Manish-404/zip-ties-3d-bike/out/loads.md

| Loop tension | Per tooth | Bearing | Root shear | Fillet peak (FEM-scaled) | Core tension |
|---|---|---|---|---|---|
| 100 N | 50 N | 4.6 MPa | 2.0 MPa | 13.0 MPa | 2.8 MPa |
| 200 N | 100 N | 9.2 MPa | 4.1 MPa | 26.0 MPa | 5.6 MPa |
| 300 N | 150 N | 13.8 MPa | 6.1 MPa | 39.0 MPa | 8.3 MPa |

| Model | cc | Engine torque | Kerb | Rear tyre | Rear load | Traction force (snow) | Wheel torque (snow) | Loop tension, 1 strap | 2 straps | Wheel torque the lock can hold (1 / 2 straps) |
|---|---|---|---|---|---|---|---|---|---|---|
| Hunter 350 Retro | 349 | 27 Nm | 177 kg | 120/80-17 | 1360 N | 476 N | 144 Nm | 264 N | 132 N | 163 / 327 Nm |
| Hunter 350 Metro | 349 | 27 Nm | 181 kg | 140/70-17 | 1381 N | 483 N | 147 Nm | 269 N | 134 N | 164 / 329 Nm |
| Meteor 350 | 349 | 27 Nm | 191 kg | 140/70-17 | 1435 N | 502 N | 153 Nm | 279 N | 140 N | 164 / 329 Nm |
| Classic 350 | 349 | 27 Nm | 195 kg | 120/80-18 | 1457 N | 510 N | 161 Nm | 283 N | 142 N | 170 / 340 Nm |
| Himalayan 450 | 452 | 40 Nm | 196 kg | 140/80-17 | 1462 N | 512 N | 163 Nm | 284 N | 142 N | 172 / 344 Nm |
| Continental GT 650 | 648 | 52.3 Nm | 202 kg | 130/70-18 | 1495 N | 523 N | 162 Nm | 291 N | 145 N | 167 / 335 Nm |
| Interceptor 650 | 648 | 52 Nm | 213 kg | 130/70-18 | 1554 N | 544 N | 169 Nm | 302 N | 151 N | 167 / 335 Nm |
| Super Meteor 650 | 648 | 52.3 Nm | 241 kg | 150/80-16 | 1705 N | 597 N | 187 Nm | 332 N | 166 N | 169 / 339 Nm |
