Manish-404/zip-ties-3d-bike/docs/images/buckle.jpg

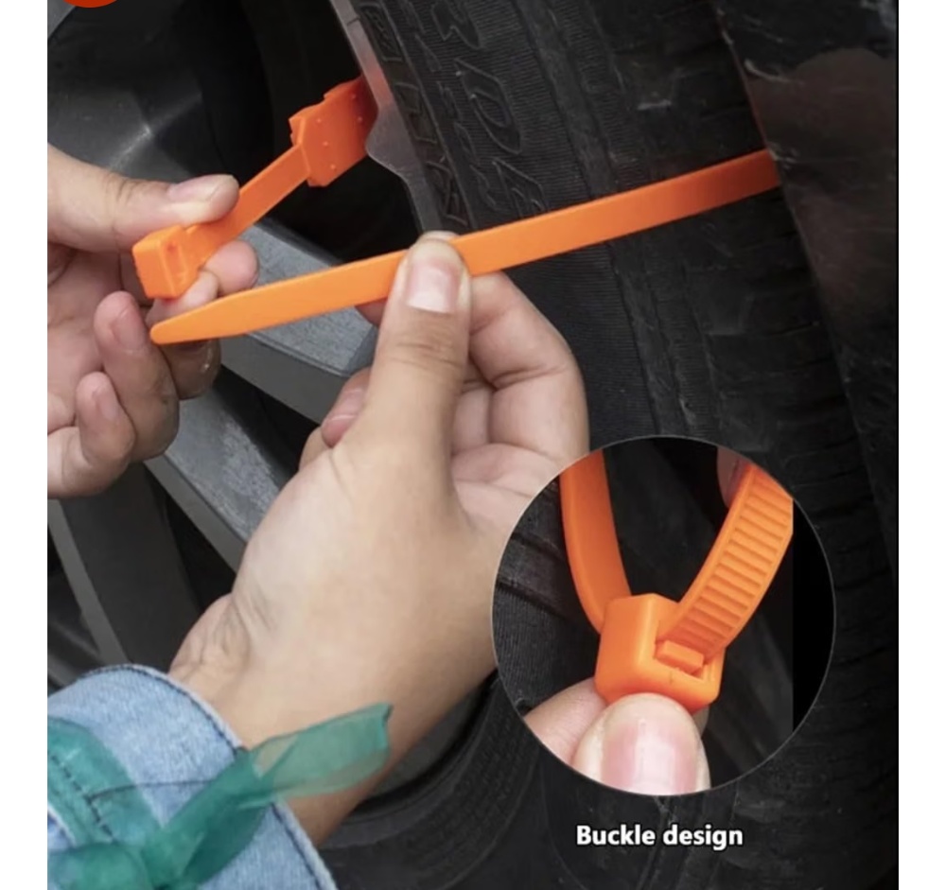
docs/images/buckle.jpg
