Manish-404/zip-ties-3d-bike/docs/images/features.jpg

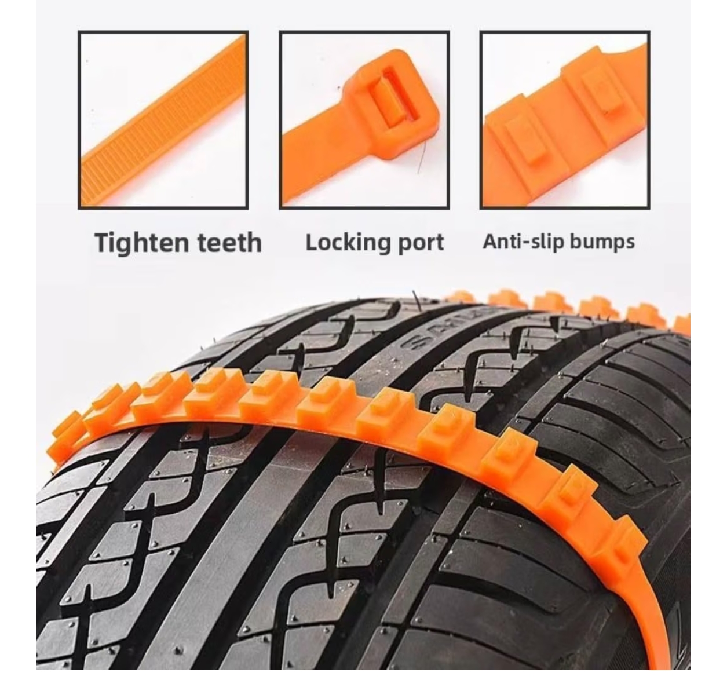
docs/images/features.jpg
