Manish-404/zip-ties-3d-bike/docs/images/lugs.jpg

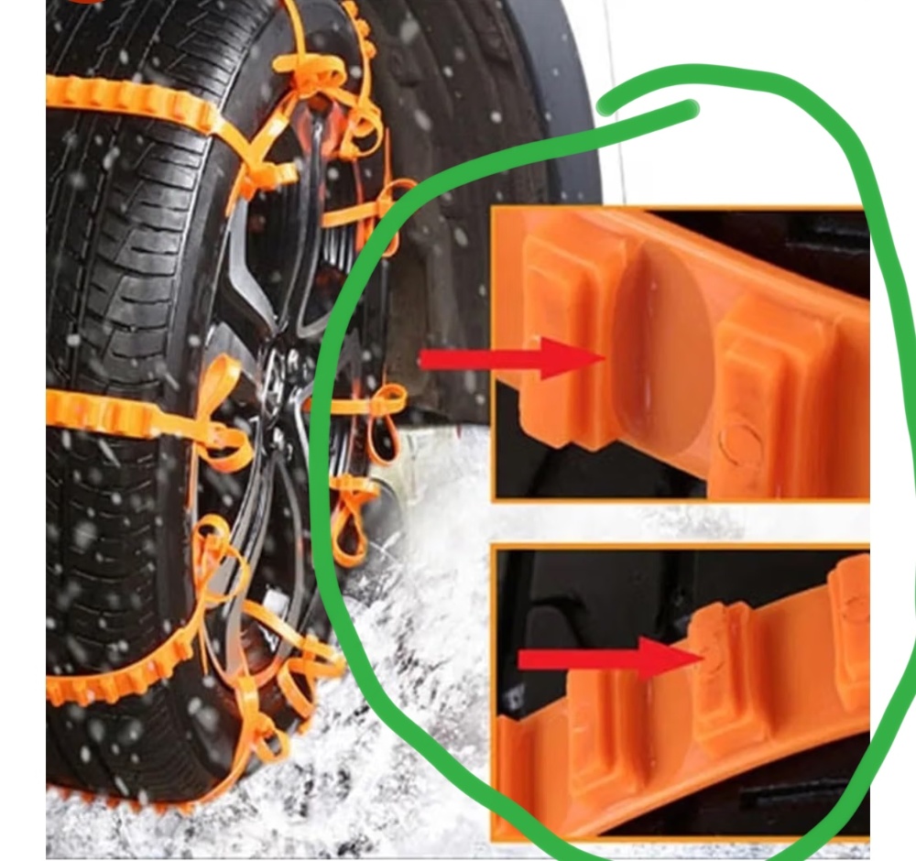
docs/images/lugs.jpg
