Manish-404/zip-ties-3d-bike/docs/images/plate_coupon.png

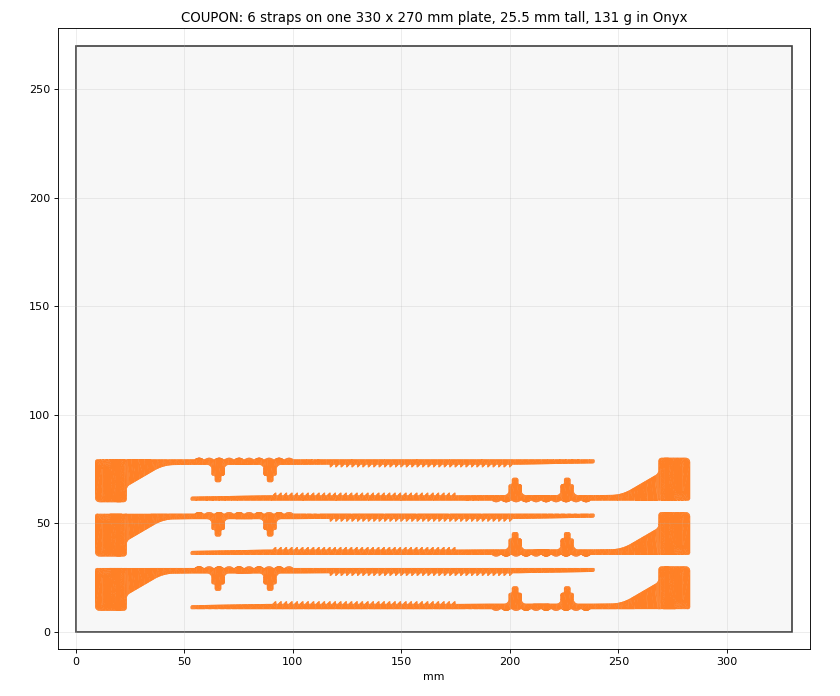
docs/images/plate_coupon.png
