Manish-404/zip-ties-3d-bike/docs/images/plate_metro_front.png

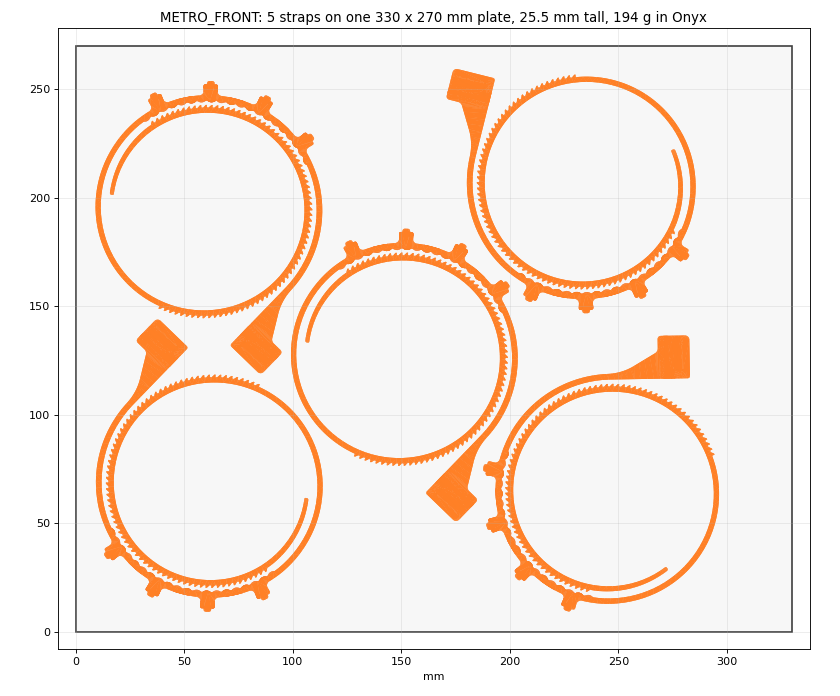
docs/images/plate_metro_front.png
