Manish-404/zip-ties-3d-bike/docs/images/plate_retro_rear.png

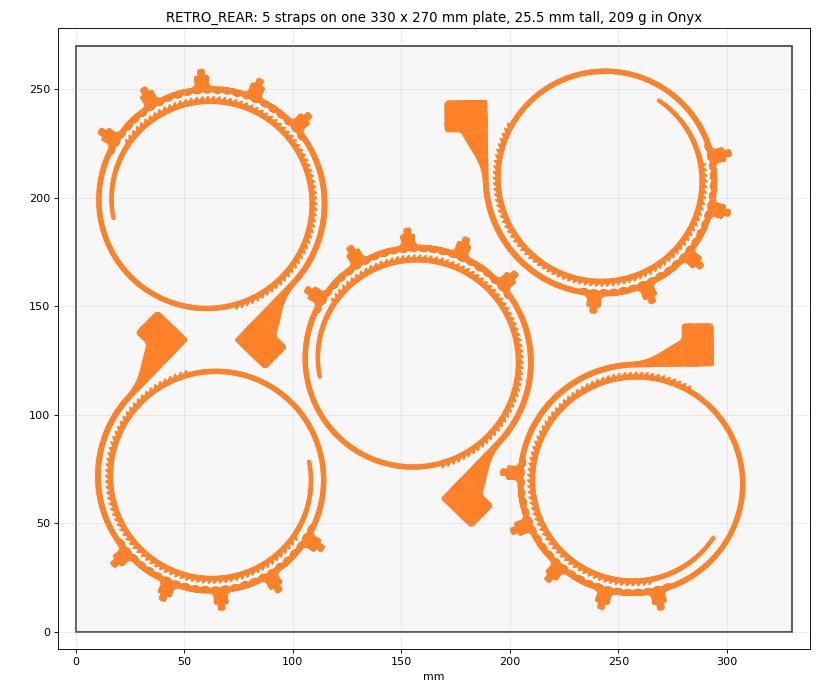
docs/images/plate_retro_rear.png
