Manish-404/zip-ties-3d-bike/docs/images/poster.jpg

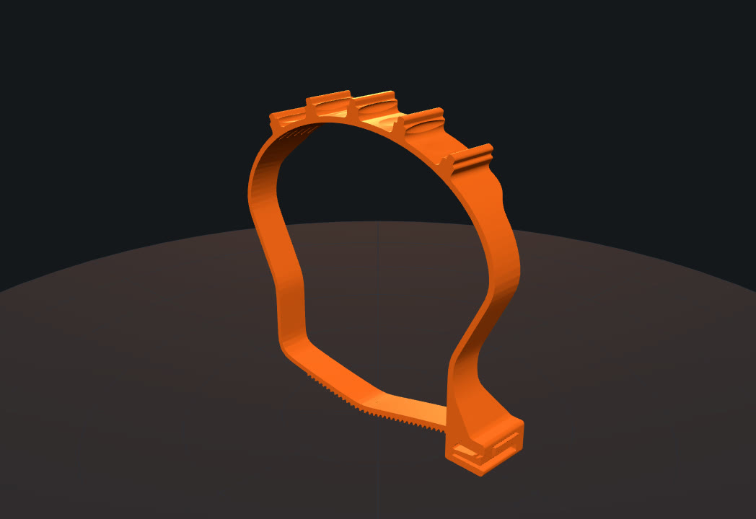
docs/images/poster.jpg
