Manish-404/zip-ties-3d-bike/docs/images/poster.png

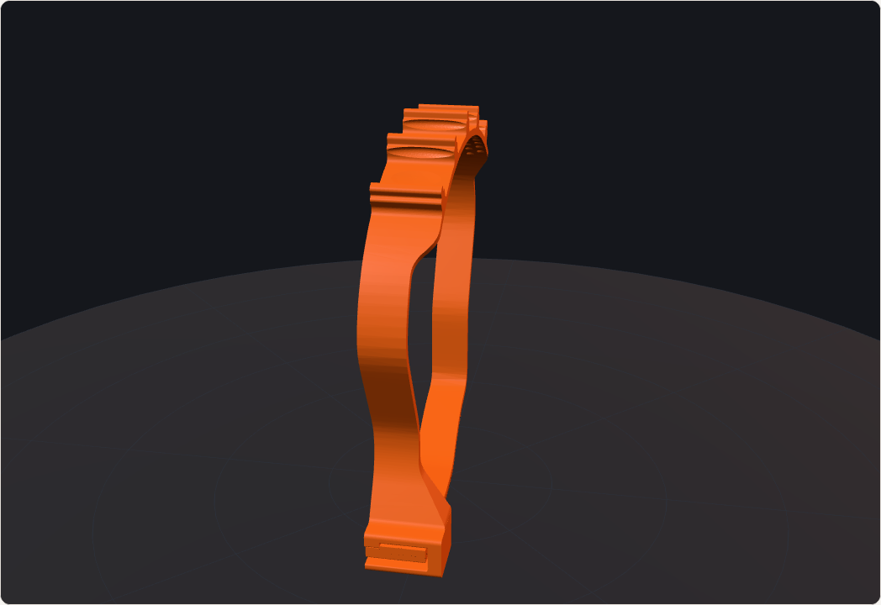
docs/images/poster.png
