Manish-404/zip-ties-3d-bike/docs/images/snow.jpg

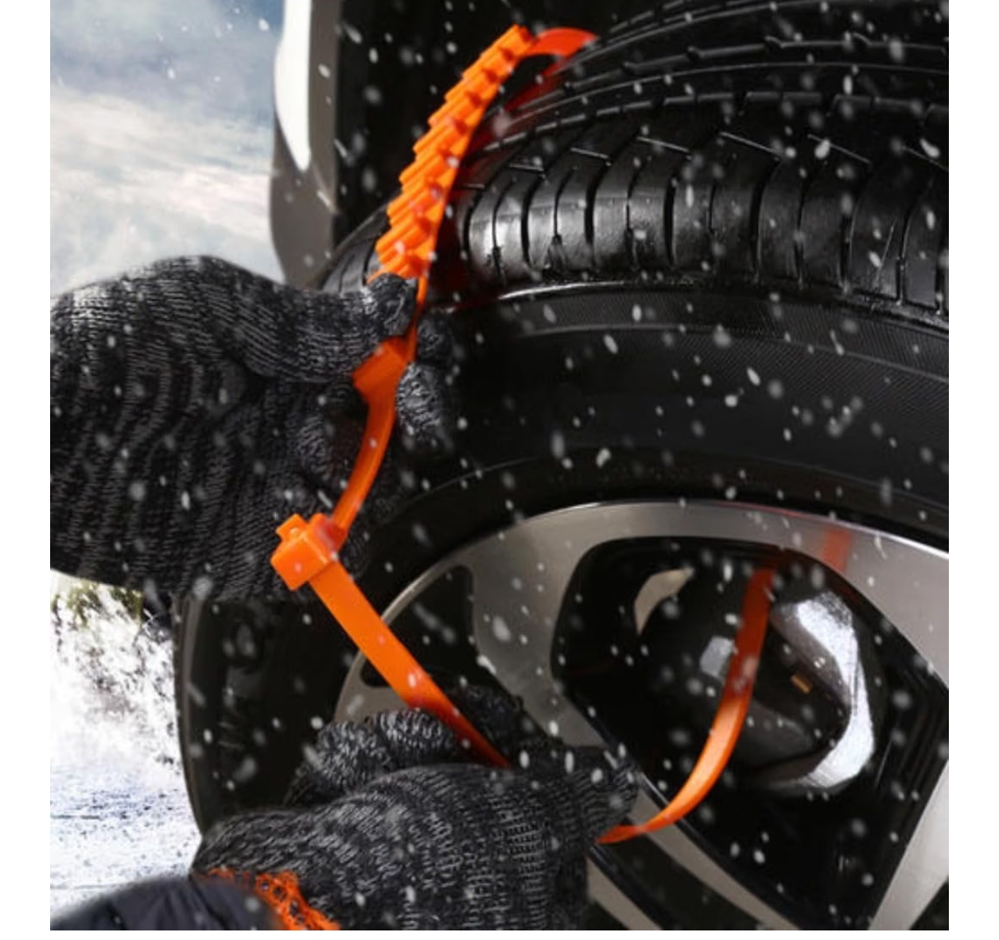
docs/images/snow.jpg
