Manish-404/zip-ties-3d-bike/docs/images/strap-fit.jpg

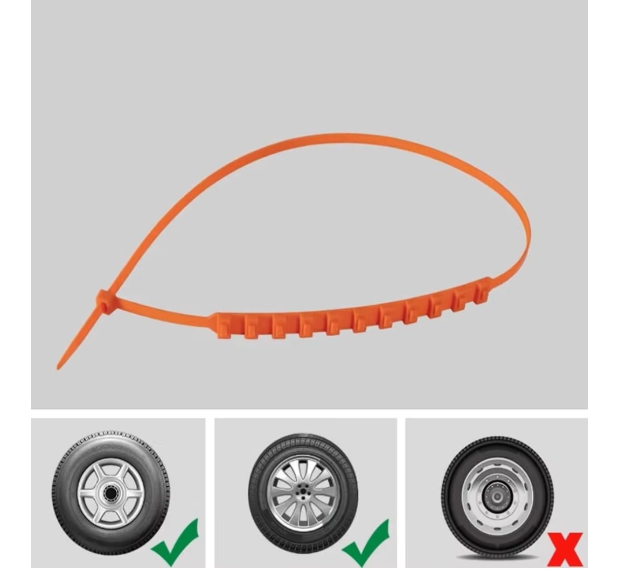
docs/images/strap-fit.jpg
