Manish-404/zip-ties-3d-bike/docs/images/v1_preview.png

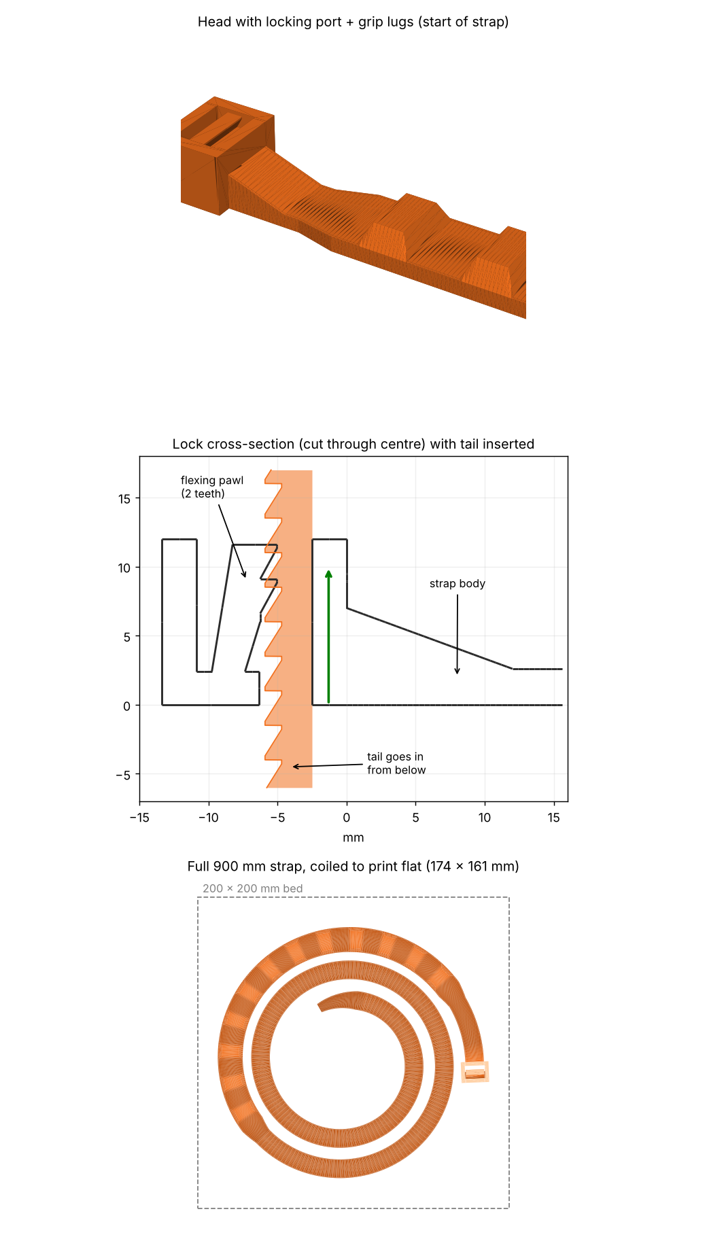
docs/images/v1_preview.png
