Manish-404/zip-ties-3d-bike/docs/models/hunter350_rear_loop.stl

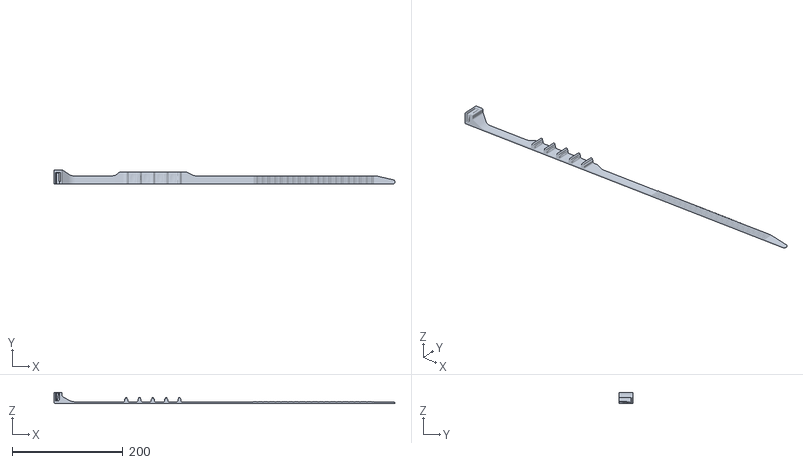
[picture p18: CAD file, 2026-10-31]
docs/models/hunter350_rear_loop.stl
615.0 x 25.5 x 20.4
