Manish-404/zip-ties-3d-bike/out/hunter350_snow_straps.FCStd

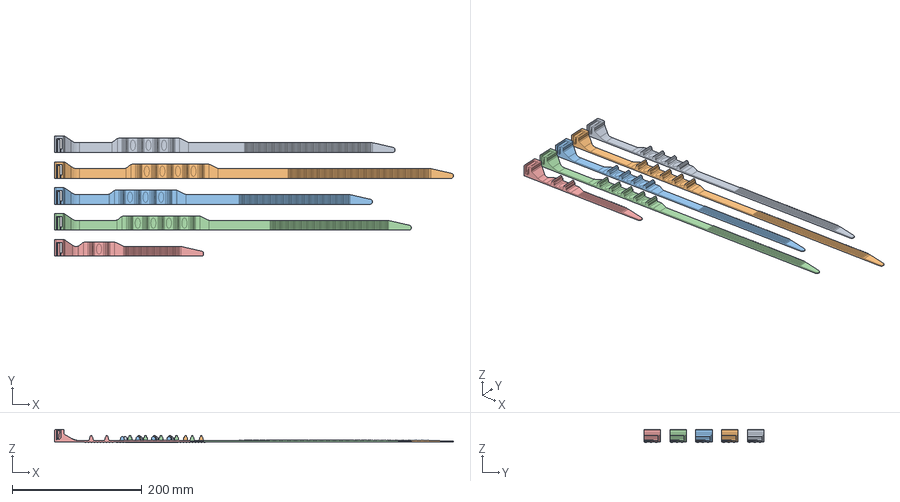
[picture p19: CAD file, 2026-10-31]
out/hunter350_snow_straps.FCStd
615.0 x 185.5 x 20.4 mm
Strap_METRO_FRONT
Strap_METRO_REAR
Strap_RETRO_FRONT
Strap_RETRO_REAR
Strap_COUPON
