Manish-404/zip-ties-3d-bike/out/lite/hunter350_coupon_lite.step

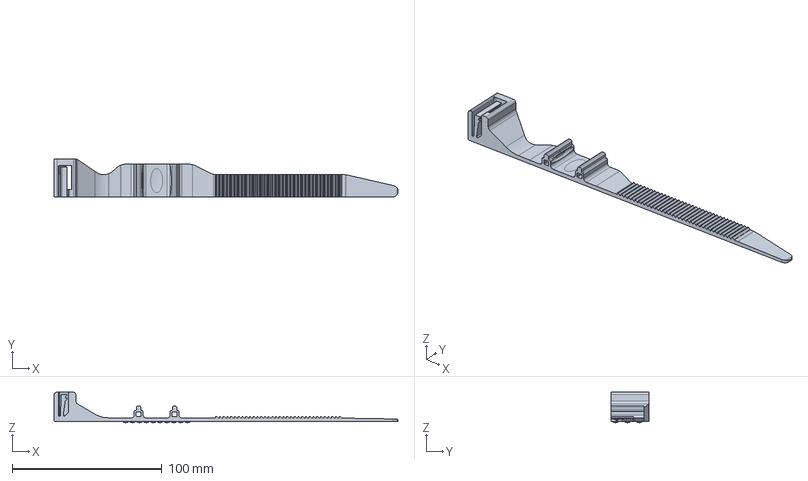
[picture p20: CAD file, 2026-10-31]
out/lite/hunter350_coupon_lite.step
230.0 x 25.5 x 20.4 mm
