Manish-404/zip-ties-3d-bike/out/lite/plates/hunter350_coupon_lite_PLATE_6up.stl

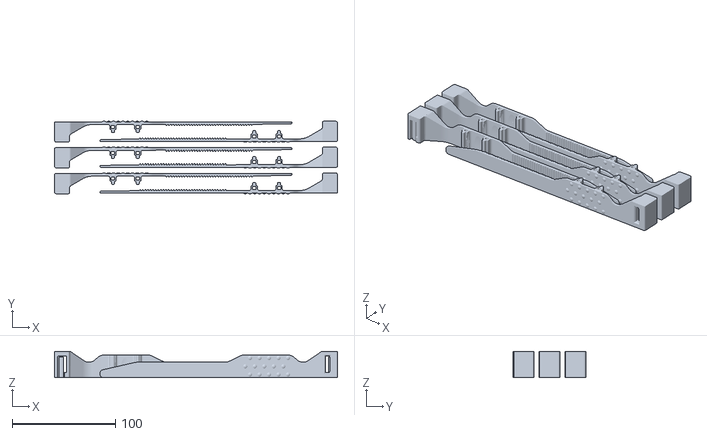
[picture p21: CAD file, 2026-10-31]
out/lite/plates/hunter350_coupon_lite_PLATE_6up.stl
274.0 x 70.4 x 25.5
