Manish-404/zip-ties-3d-bike/out/lite_rect/hunter350_metro_front_rect_lite_PRINT_on_edge_coil.stl

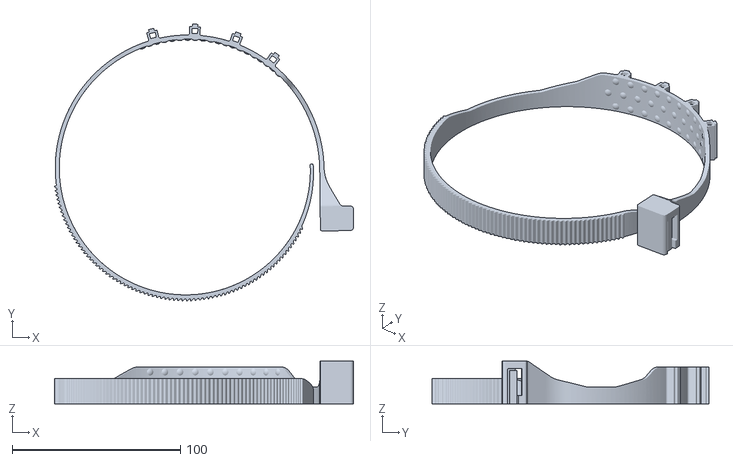
[picture p22: CAD file, 2026-10-31]
out/lite_rect/hunter350_metro_front_rect_lite_PRINT_on_edge_coil.stl
177.7 x 164.6 x 25.5
