Manish-404/zip-ties-3d-bike/out/lite_rect/plates/hunter350_metro_front_rect_lite_PLATE_5up.stl

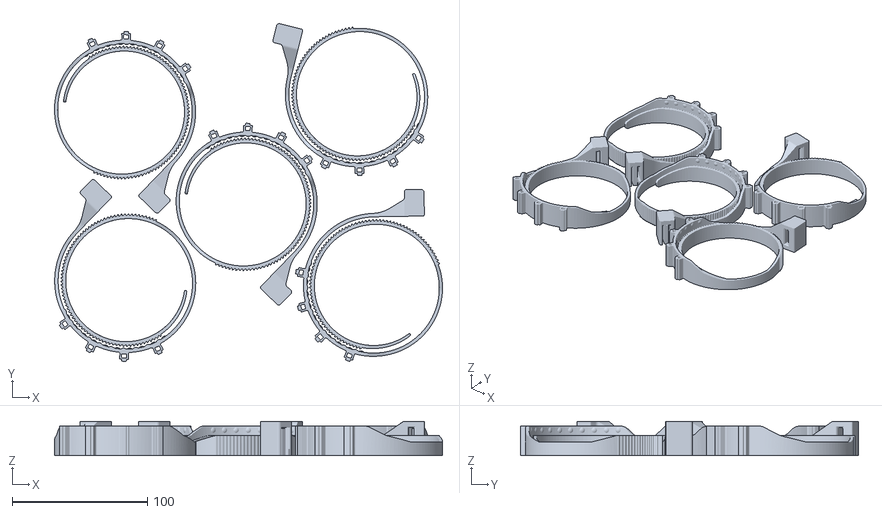
[picture p23: CAD file, 2026-10-31]
out/lite_rect/plates/hunter350_metro_front_rect_lite_PLATE_5up.stl
287.1 x 249.9 x 25.5
