Manish-404/zip-ties-3d-bike/out/plates/hunter350_retro_rear_PLATE_5up.stl

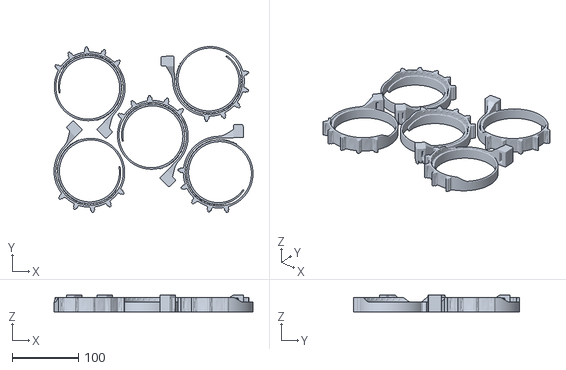
[picture p24: CAD file, 2026-10-31]
out/plates/hunter350_retro_rear_PLATE_5up.stl
299.4 x 249.6 x 25.5
