Manish-404/zip-ties-3d-bike/out/rect/hunter350_metro_rear_rect.step

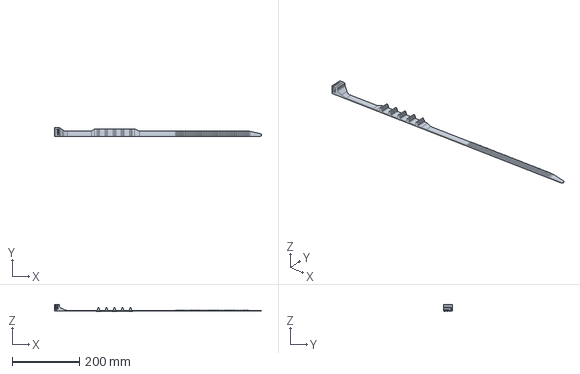
[picture p25: CAD file, 2026-10-31]
out/rect/hunter350_metro_rear_rect.step
615.0 x 25.5 x 20.4 mm
