Manish-404/zip-ties-3d-bike/out/hunter350_coupon_straight.stl

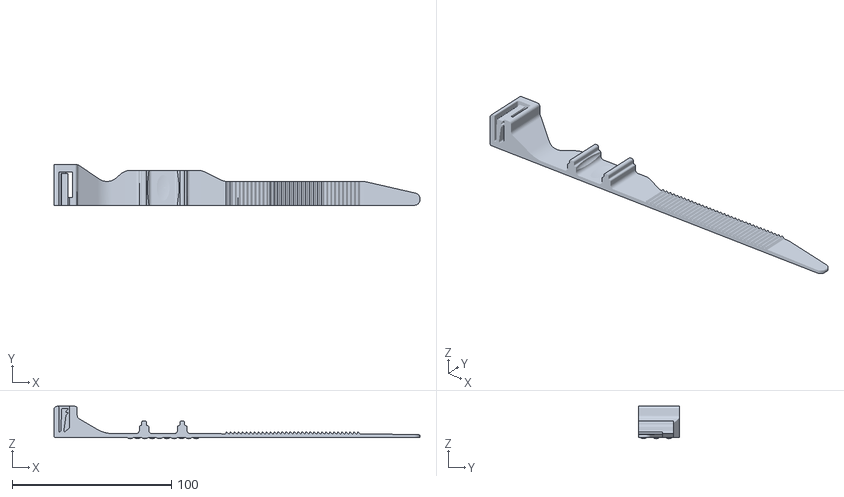
[picture p26: CAD file, 2026-10-31]
out/hunter350_coupon_straight.stl
230.0 x 25.5 x 20.4
