Manish-404/zip-ties-3d-bike/out/lite_rect/plates/hunter350_metro_rear_rect_lite_PLATE_5up.stl

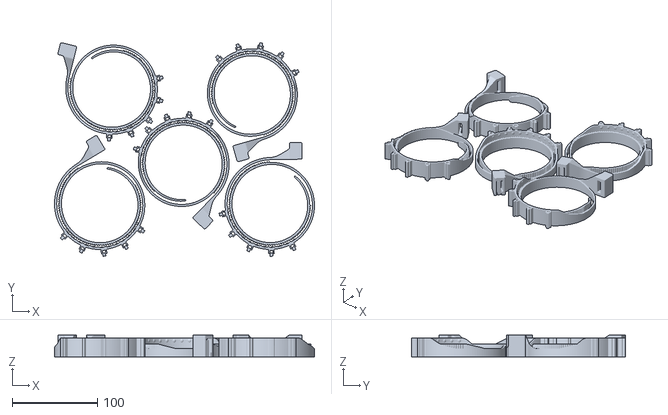
[picture p27: CAD file, 2026-10-31]
out/lite_rect/plates/hunter350_metro_rear_rect_lite_PLATE_5up.stl
305.0 x 250.6 x 25.5
