Manish-404/zip-ties-3d-bike/out/plates/hunter350_coupon_PLATE_6up.stl

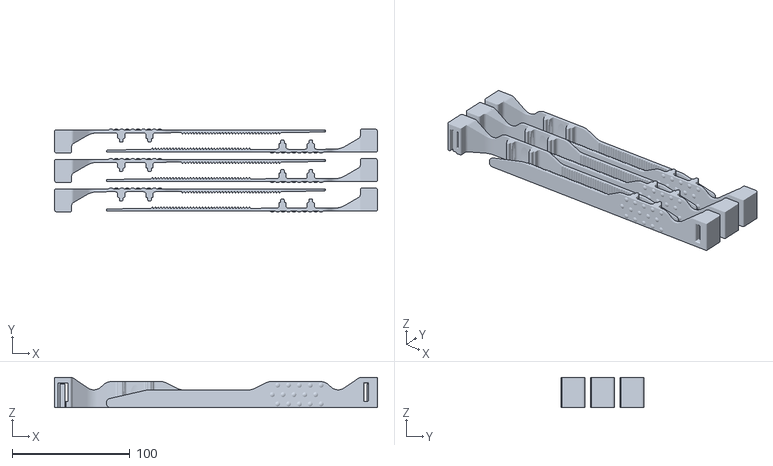
[picture p28: CAD file, 2026-10-31]
out/plates/hunter350_coupon_PLATE_6up.stl
274.0 x 70.4 x 25.5
