Manish-404/zip-ties-3d-bike/out/rect/hunter350_retro_front_rect_straight.stl

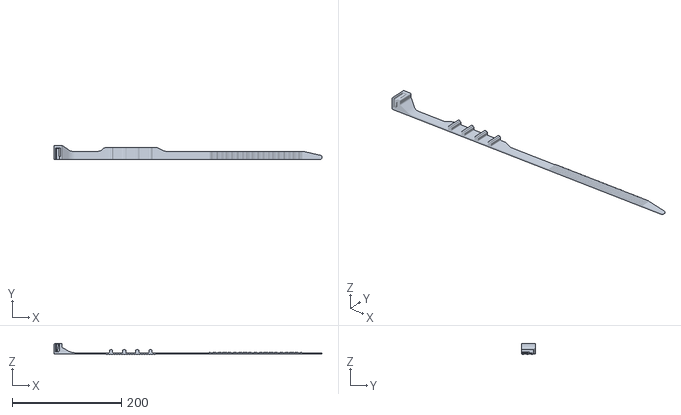
[picture p29: CAD file, 2026-10-31]
out/rect/hunter350_retro_front_rect_straight.stl
490.0 x 25.5 x 20.4
