Manish-404/zip-ties-3d-bike/docs/models/hunter350_front_straight.stl

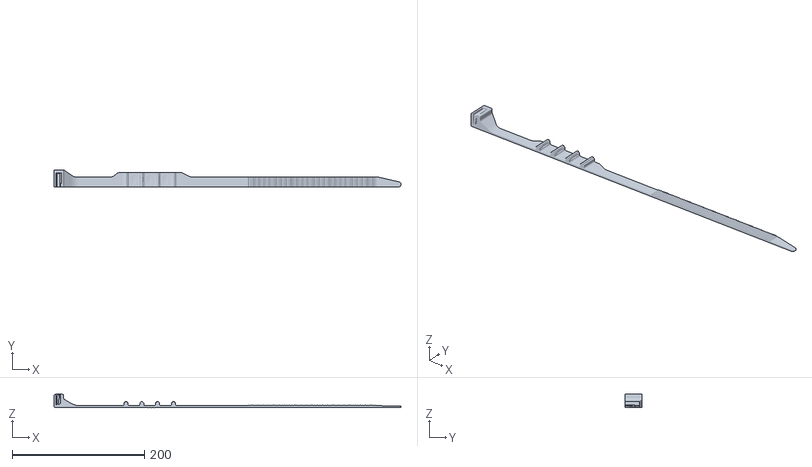
[picture p30: CAD file, 2026-10-31]
docs/models/hunter350_front_straight.stl
525.0 x 25.5 x 20.4
