Manish-404/zip-ties-3d-bike/out/hunter350_metro_rear_PRINT_on_edge_coil.stl

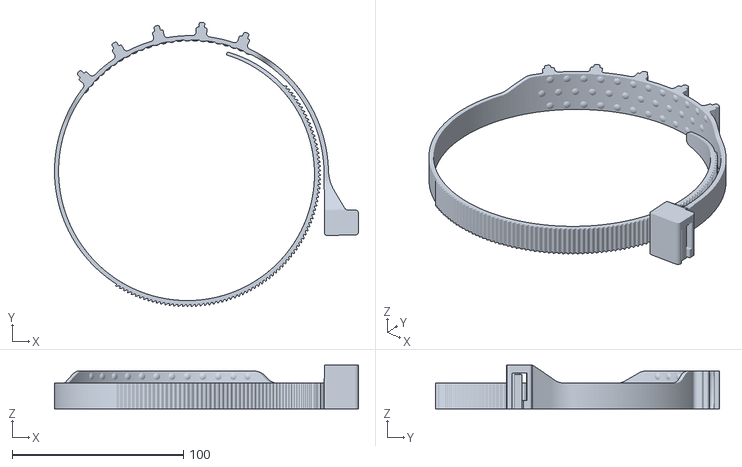
[picture p31: CAD file, 2026-10-31]
out/hunter350_metro_rear_PRINT_on_edge_coil.stl
177.3 x 165.9 x 25.5
