Manish-404/zip-ties-3d-bike/out/lite/plates/hunter350_retro_front_lite_PLATE_5up.stl

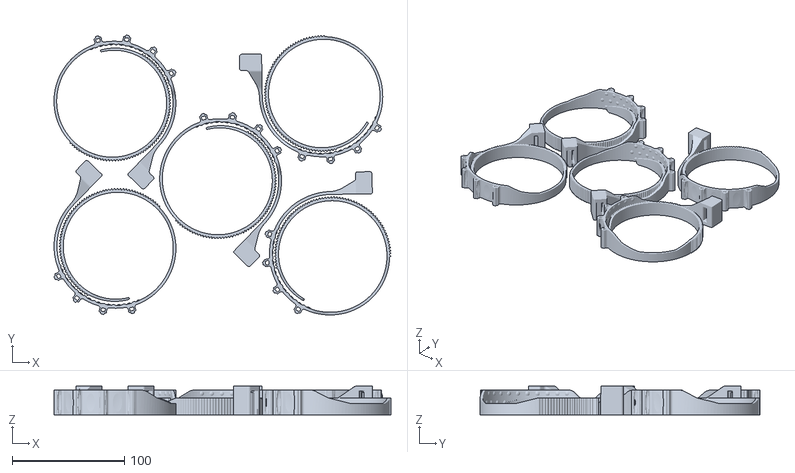
[picture p32: CAD file, 2026-10-31]
out/lite/plates/hunter350_retro_front_lite_PLATE_5up.stl
299.8 x 249.0 x 25.5
