Manish-404/zip-ties-3d-bike/out/lite_rect/hunter350_retro_front_rect_lite_PRINT_on_edge_coil.stl

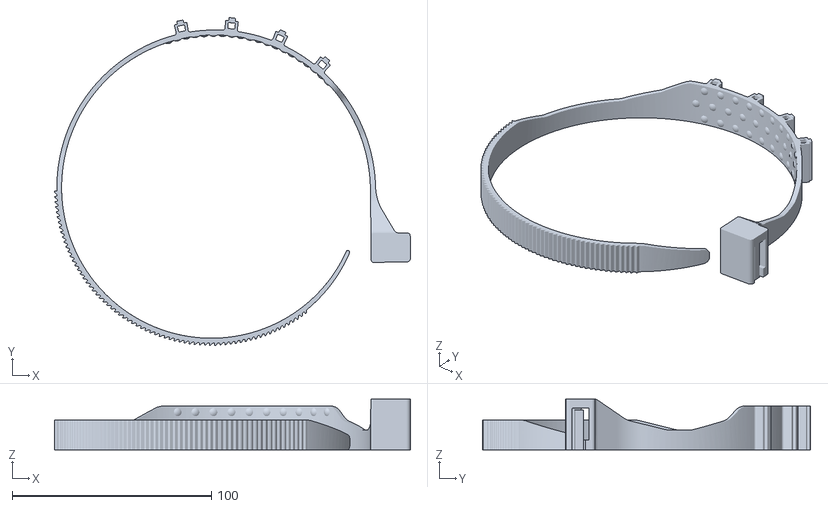
[picture p33: CAD file, 2026-10-31]
out/lite_rect/hunter350_retro_front_rect_lite_PRINT_on_edge_coil.stl
178.5 x 164.3 x 25.5
