Manish-404/zip-ties-3d-bike/out/lite_rect/hunter350_retro_rear_rect_lite_straight.stl

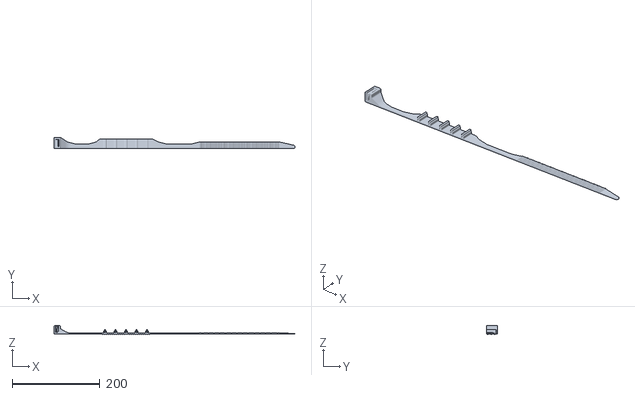
[picture p35: CAD file, 2026-10-31]
out/lite_rect/hunter350_retro_rear_rect_lite_straight.stl
550.0 x 25.5 x 20.4
