Manish-404/zip-ties-3d-bike/out/lite/plates/hunter350_metro_rear_lite_PLATE_5up.stl

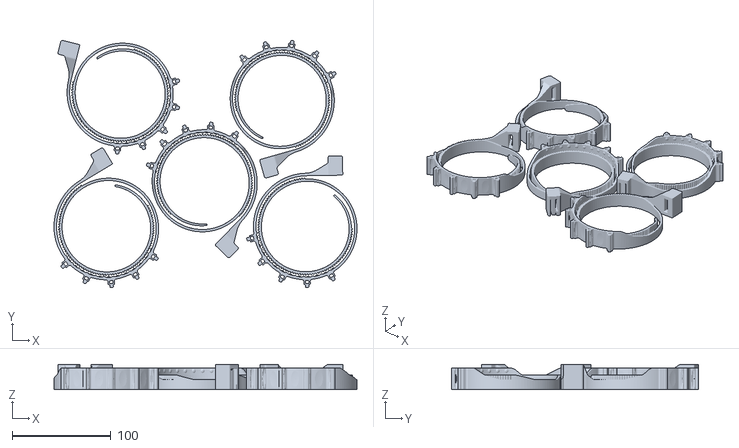
[picture p36: CAD file, 2026-10-31]
out/lite/plates/hunter350_metro_rear_lite_PLATE_5up.stl
307.0 x 250.5 x 25.5
