Manish-404/zip-ties-3d-bike/out/hunter350_metro_front_installed_pose.stl

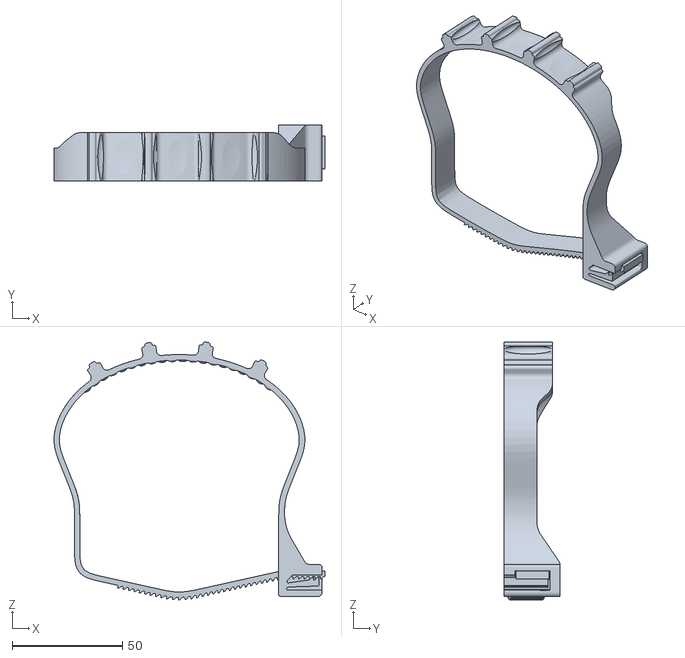
[picture p37: CAD file, 2026-10-31]
out/hunter350_metro_front_installed_pose.stl
122.9 x 25.5 x 117.0
