Manish-404/zip-ties-3d-bike/out/lite/hunter350_retro_rear_lite_PRINT_on_edge_coil.stl

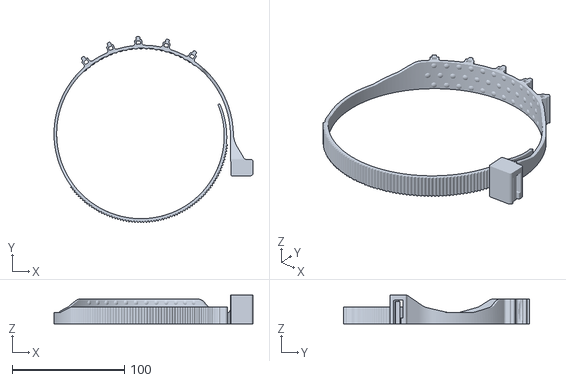
[picture p38: CAD file, 2026-10-31]
out/lite/hunter350_retro_rear_lite_PRINT_on_edge_coil.stl
177.3 x 166.0 x 25.5
