Manish-404/zip-ties-3d-bike/out/hunter350_retro_rear_installed_pose.stl

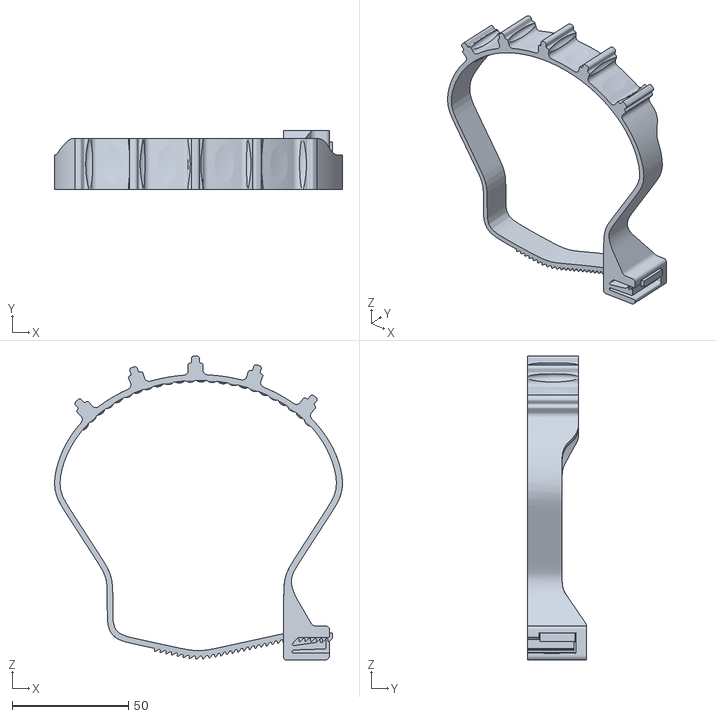
[picture p39: CAD file, 2026-10-31]
out/hunter350_retro_rear_installed_pose.stl
123.9 x 25.5 x 130.7
