Manish-404/zip-ties-3d-bike/out/lite/hunter350_retro_front_lite_straight.stl

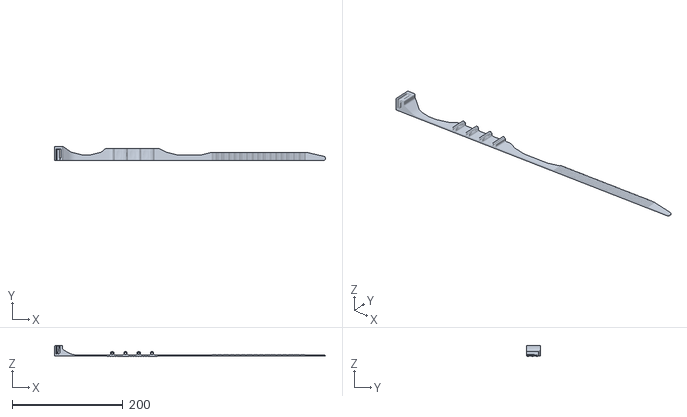
[picture p40: CAD file, 2026-10-31]
out/lite/hunter350_retro_front_lite_straight.stl
490.0 x 25.5 x 20.4
