Manish-404/zip-ties-3d-bike/out/rect/hunter350_metro_rear_rect_installed_pose.stl

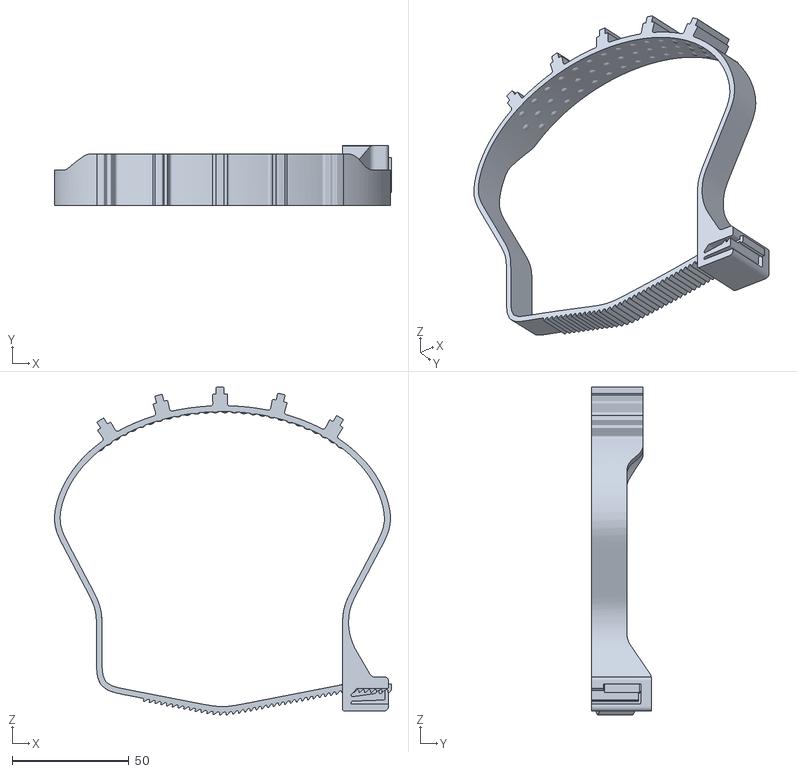
[picture p42: CAD file, 2026-10-28]
out/rect/hunter350_metro_rear_rect_installed_pose.stl
144.3 x 25.5 x 140.4
