Manish-404/zip-ties-3d-bike/out/rect/hunter350_retro_front_rect_installed_pose.stl

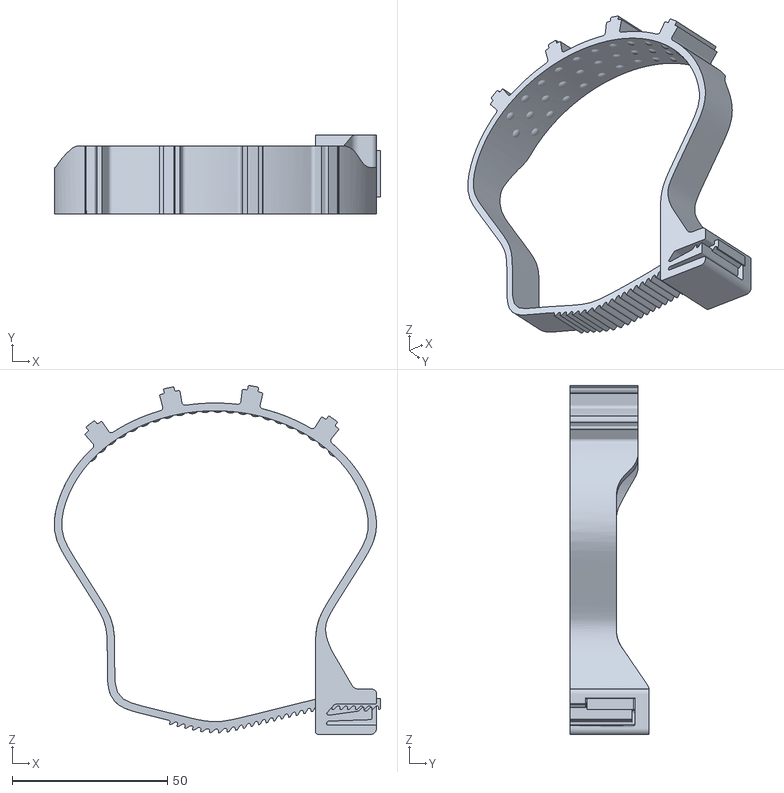
[picture p43: CAD file, 2026-10-28]
out/rect/hunter350_retro_front_rect_installed_pose.stl
105.0 x 25.5 x 112.4
