Manish-404/zip-ties-3d-bike/(list of files, cad)

Other CAD files:
out/rect/plates/hunter350_retro_rear_rect_PLATE_5up.stl
out/lite/hunter350_snow_straps.FCStd
out/lite/plates/hunter350_metro_front_lite_PLATE_5up.stl
out/lite_rect/hunter350_coupon_rect_lite.step
out/rect/plates/hunter350_coupon_rect_PLATE_6up.stl
out/lite/hunter350_metro_rear_lite_straight.stl
out/plates/hunter350_metro_front_PLATE_5up.stl
out/rect/hunter350_retro_front_rect.step
out/rect/plates/hunter350_metro_front_rect_PLATE_5up.stl
out/hunter350_metro_front_PRINT_on_edge_coil.stl
out/lite/hunter350_coupon_lite_straight.stl
out/lite/plates/hunter350_retro_rear_lite_PLATE_5up.stl
out/lite_rect/plates/hunter350_retro_front_rect_lite_PLATE_5up.stl
out/plates/hunter350_retro_front_PLATE_5up.stl
out/rect/hunter350_coupon_rect.step
out/rect/plates/hunter350_retro_front_rect_PLATE_5up.stl
out/lite/hunter350_metro_rear_lite.step
out/lite_rect/hunter350_coupon_rect_lite_PRINT_on_edge.stl
out/lite_rect/plates/hunter350_retro_rear_rect_lite_PLATE_5up.stl
out/plates/hunter350_metro_rear_PLATE_5up.stl
out/rect/hunter350_coupon_rect_PRINT_on_edge.stl
out/rect/plates/hunter350_metro_rear_rect_PLATE_5up.stl
out/lite/hunter350_metro_rear_lite_PRINT_on_edge_coil.stl
out/lite_rect/hunter350_metro_rear_rect_lite.step
out/rect/hunter350_metro_front_rect.step
out/hunter350_retro_front_PRINT_on_edge_coil.stl
out/lite_rect/hunter350_retro_rear_rect_lite.step
out/rect/hunter350_coupon_rect_straight.stl
out/hunter350_coupon.step
out/lite/hunter350_metro_front_lite_straight.stl
out/lite_rect/hunter350_metro_rear_rect_lite_straight.stl
out/rect/hunter350_metro_rear_rect_straight.stl
out/hunter350_retro_rear_straight.stl
out/lite/hunter350_metro_front_lite.step
out/lite_rect/hunter350_metro_rear_rect_lite_PRINT_on_edge_coil.stl
out/rect/hunter350_retro_front_rect_PRINT_on_edge_coil.stl
out/hunter350_coupon_PRINT_on_edge.stl
out/lite/hunter350_metro_front_lite_PRINT_on_edge_coil.stl
out/lite_rect/hunter350_metro_front_rect_lite.step
out/rect/hunter350_retro_rear_rect_straight.stl
out/lite/hunter350_retro_front_lite_PRINT_on_edge_coil.stl
out/lite_rect/hunter350_retro_front_rect_lite.step
out/rect/hunter350_retro_rear_rect.step
out/lite/hunter350_retro_rear_lite_straight.stl
out/lite_rect/hunter350_retro_front_rect_lite_straight.stl
out/rect/hunter350_retro_rear_rect_PRINT_on_edge_coil.stl
out/hunter350_retro_front_straight.stl
out/lite_rect/hunter350_retro_rear_rect_lite_PRINT_on_edge_coil.stl
out/hunter350_metro_rear.step
out/lite/hunter350_retro_front_lite.step
out/lite_rect/hunter350_coupon_rect_lite_straight.stl
out/rect/hunter350_metro_front_rect_straight.stl
out/hunter350_metro_front.step
out/lite/hunter350_retro_rear_lite.step
out/lite_rect/hunter350_metro_front_rect_lite_straight.stl
out/rect/hunter350_metro_front_rect_PRINT_on_edge_coil.stl
out/hunter350_retro_rear.step
out/lite/hunter350_coupon_lite_PRINT_on_edge.stl
out/lite_rect/hunter350_snow_straps.FCStd
out/rect/hunter350_snow_straps.FCStd
out/hunter350_retro_front.step
out/hunter350_retro_rear_PRINT_on_edge_coil.stl
out/rect/hunter350_retro_rear_rect_installed_pose.stl
out/hunter350_metro_rear_installed_pose.stl
out/hunter350_retro_front_installed_pose.stl
out/rect/hunter350_metro_front_rect_installed_pose.stl
legacy/snow_strap_900mm_spiral.stl
legacy/snow_strap_lock_test_180mm_1.stl
