Manish-404/zip-ties-3d-bike/docs/images/install.jpg

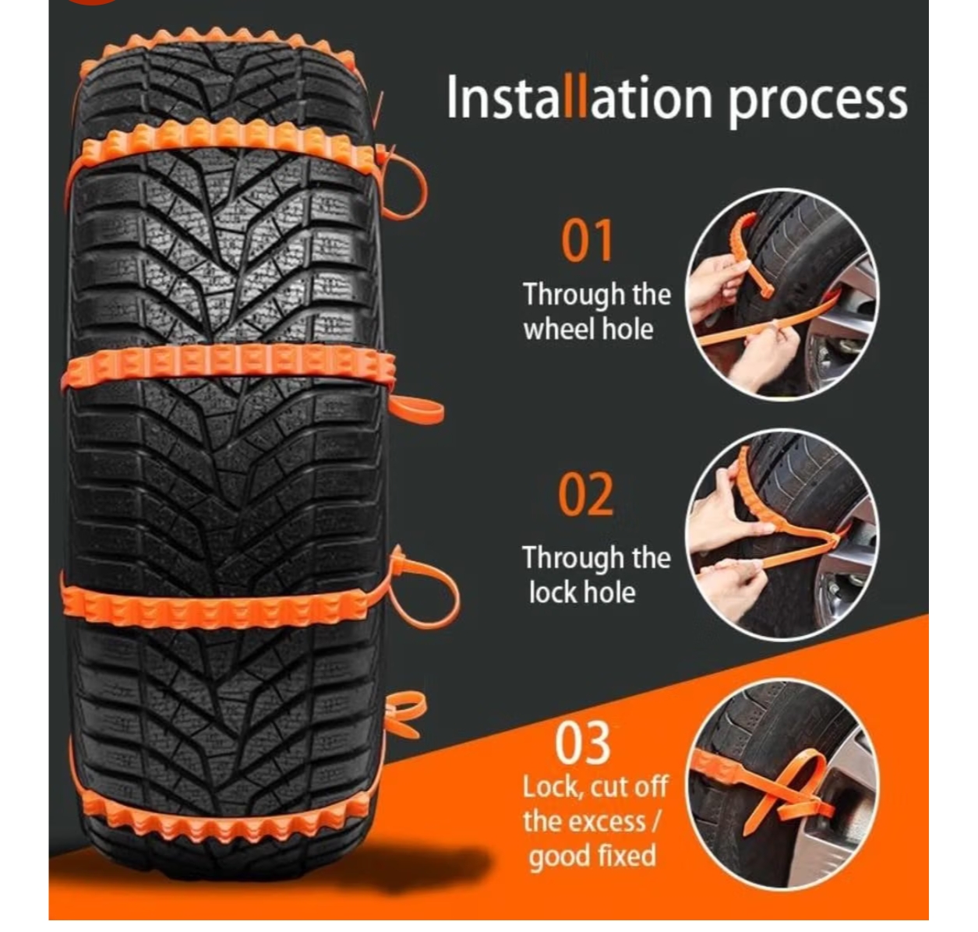
docs/images/install.jpg
