Manish-404/zip-ties-3d-bike/(commit log)

2026-10-24 Hunter 350 snow-traction strap: FreeCAD generator, STEP/STL, README
    [hunter350_front.step, hunter350_front_straight.stl, hunter350_rear.step, hunter350_rear_straight.stl, snow_strap_900mm_spiral.stl, snow_strap_lock_test_180mm_1.stl]
2026-10-24 Add project page with 3D viewer, 360 video and reference photos
    [hunter350_front_straight.stl, hunter350_rear_loop.stl, hunter350_rear_straight.stl]
2026-10-26 Add v2 outputs, per-tooth pressure, torque by Royal Enfield model, filament guide; drop outdated images
    [hunter350_coupon.step, hunter350_coupon_PRINT_on_edge.stl, hunter350_coupon_straight.stl, hunter350_front.step, hunter350_front_straight.stl, hunter350_metro_front.step, hunter350_metro_front_PRINT_on_edge_coil.stl, hunter350_metro_front_installed_pose.stl]
2026-10-26 Page: tooth pressure, torque by Royal Enfield model, filament guide, lock and fit diagrams
2026-10-27 Replace tyre-side micro-ribs with raised grip dots; rebuild all presets, previews, models and video
    [hunter350_coupon.step, hunter350_coupon_PRINT_on_edge.stl, hunter350_coupon_straight.stl, hunter350_front_straight.stl, hunter350_metro_front.step, hunter350_metro_front_PRINT_on_edge_coil.stl, hunter350_metro_front_installed_pose.stl, hunter350_metro_front_straight.stl]
2026-10-28 Space grip dots 8 mm apart (was 5 mm) to suit the rear tyre's groove spacing
2026-10-28 Add built _RECT straps: STEP, STL and print coils for all presets
    [hunter350_coupon_rect.step, hunter350_coupon_rect_PRINT_on_edge.stl, hunter350_coupon_rect_straight.stl, hunter350_metro_front_rect.step, hunter350_metro_front_rect_PRINT_on_edge_coil.stl, hunter350_metro_front_rect_installed_pose.stl, hunter350_metro_front_rect_straight.stl, hunter350_metro_rear_rect.step]
2026-10-28 Rebuild standard presets with 8 mm dot spacing
    [hunter350_coupon.step, hunter350_coupon_PRINT_on_edge.stl, hunter350_coupon_straight.stl, hunter350_metro_front.step, hunter350_metro_front_PRINT_on_edge_coil.stl, hunter350_metro_front_installed_pose.stl, hunter350_metro_front_straight.stl, hunter350_metro_rear.step]
2026-10-28 Refresh page previews and 3D models for the new dot spacing
    [hunter350_front_straight.stl, hunter350_rear_loop.stl, hunter350_rear_straight.stl]
2026-10-28 Docs: 8 mm dot spacing and the _RECT variant
2026-10-30 Add plate_layout: pack several print coils onto one build plate
2026-10-30 Export multi-strap print plates (330 x 270 bed), add Onyx density, keep info.json on partial builds
2026-10-30 Render a top view of each print plate
2026-10-30 Add print plates: five straps per plate for each tyre, six test pieces
    [hunter350_coupon_PLATE_6up.stl, hunter350_metro_front_PLATE_5up.stl, hunter350_metro_rear_PLATE_5up.stl, hunter350_retro_front_PLATE_5up.stl, hunter350_retro_rear_PLATE_5up.stl]
2026-10-30 Add print plates for the _RECT variant
    [hunter350_coupon_rect_PLATE_6up.stl, hunter350_metro_front_rect_PLATE_5up.stl, hunter350_metro_rear_rect_PLATE_5up.stl, hunter350_retro_front_rect_PLATE_5up.stl, hunter350_retro_rear_rect_PLATE_5up.stl]
2026-10-30 Record plate size, spacing and bend strain in info.json
2026-10-30 Add plate preview images
2026-10-30 README: print several at once, Onyx notes and per-plate counts
2026-10-30 FITTING: printing plates in Onyx on a 330 x 270 bed
2026-10-30 HANDOFF: plate layout and Onyx notes
2026-10-30 Page: print plates section and Onyx in the filament table
2026-10-31 Add _LITE variant: lug tunnels and a 10 mm strap where it never enters the head
2026-10-31 Add built _LITE straps and plates
    [hunter350_coupon_lite.step, hunter350_coupon_lite_PLATE_6up.stl, hunter350_coupon_lite_PRINT_on_edge.stl, hunter350_coupon_lite_straight.stl, hunter350_metro_front_lite.step, hunter350_metro_front_lite_PLATE_5up.stl, hunter350_metro_front_lite_PRINT_on_edge_coil.stl, hunter350_metro_front_lite_straight.stl]
2026-10-31 Add built _RECT_LITE straps and plates
    [hunter350_coupon_rect_lite.step, hunter350_coupon_rect_lite_PLATE_6up.stl, hunter350_coupon_rect_lite_PRINT_on_edge.stl, hunter350_coupon_rect_lite_straight.stl, hunter350_metro_front_rect_lite.step, hunter350_metro_front_rect_lite_PLATE_5up.stl, hunter350_metro_front_rect_lite_PRINT_on_edge_coil.stl, hunter350_metro_front_rect_lite_straight.stl]
2026-10-31 Page: mention the lighter plates
2026-10-31 Fewer, larger grip dots: 4 mm domes at 9.2 mm pitch
2026-10-31 Rebuild standard outputs and plates with the new dots
    [hunter350_coupon.step, hunter350_coupon_PLATE_6up.stl, hunter350_coupon_PRINT_on_edge.stl, hunter350_coupon_straight.stl, hunter350_metro_front.step, hunter350_metro_front_PLATE_5up.stl, hunter350_metro_front_PRINT_on_edge_coil.stl, hunter350_metro_front_installed_pose.stl]
2026-10-31 Rebuild _RECT outputs and plates with the new dots
    [hunter350_coupon_rect.step, hunter350_coupon_rect_PLATE_6up.stl, hunter350_coupon_rect_PRINT_on_edge.stl, hunter350_coupon_rect_straight.stl, hunter350_metro_front_rect.step, hunter350_metro_front_rect_PLATE_5up.stl, hunter350_metro_front_rect_PRINT_on_edge_coil.stl, hunter350_metro_front_rect_straight.stl]
2026-10-31 Rebuild _LITE and _RECT_LITE outputs and plates with the new dots
    [hunter350_coupon_lite.step, hunter350_coupon_lite_PLATE_6up.stl, hunter350_coupon_lite_PRINT_on_edge.stl, hunter350_coupon_lite_straight.stl, hunter350_coupon_rect_lite.step, hunter350_coupon_rect_lite_PLATE_6up.stl, hunter350_coupon_rect_lite_PRINT_on_edge.stl, hunter350_coupon_rect_lite_straight.stl]
2026-10-31 Page: refresh previews and models for the new dots
    [hunter350_front_straight.stl, hunter350_rear_loop.stl, hunter350_rear_straight.stl]
2026-10-31 README and HANDOFF: new dot size and spacing, plate masses
